cloyne/card-reader/README.md

# Cloyne Card Reader

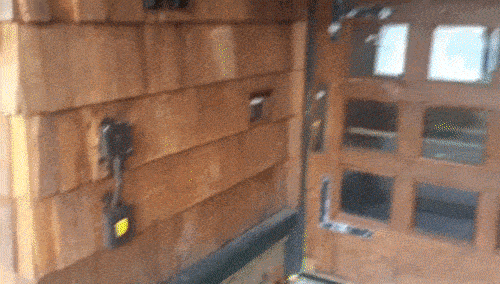
[picture p1: media/frontdoor_open.gif]


This card reader is installed at the front door of Cloyne Court Co-op. It is built off of Mike Zhong's Physics 111a final project. It scans Berkeley students' Cal1ID cards by RFID interaction, checks whether the ID is stored in the SD card adapter, and if so, triggers the door to open automatically. 

Included:

111a-final-proj.pdf:  Submitted overview of the final project, from Dec 2015.

arduino/a1.ino:   Code running on Arduino A1

arduino/a2_redacted.ino:   REDACTED code running on Arduino A2. Managers: contact mlyzhong@gmail.com for unredacted version

schematic/annotated.jpg:   Annotated image of circuit

schematic/README.txt:   readme of schematic

schematic/schematic.pdf:   PDF of schematic

More to come soon.
Mike
