cloyne/card-reader/media/unnamed.jpg

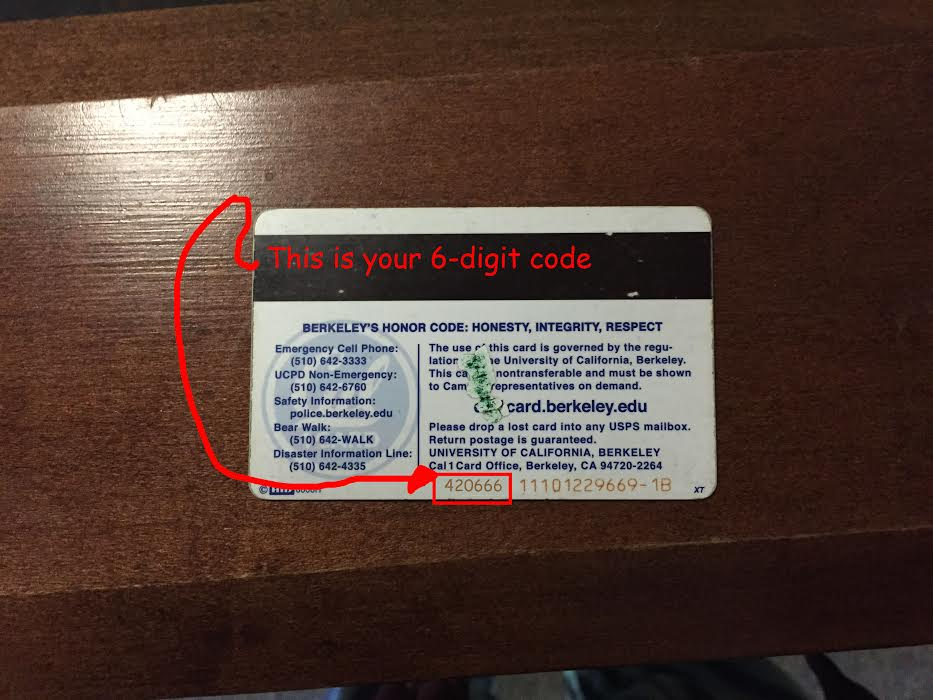
media/unnamed.jpg
