cloyne/card-reader/schematic/annotated.jpg

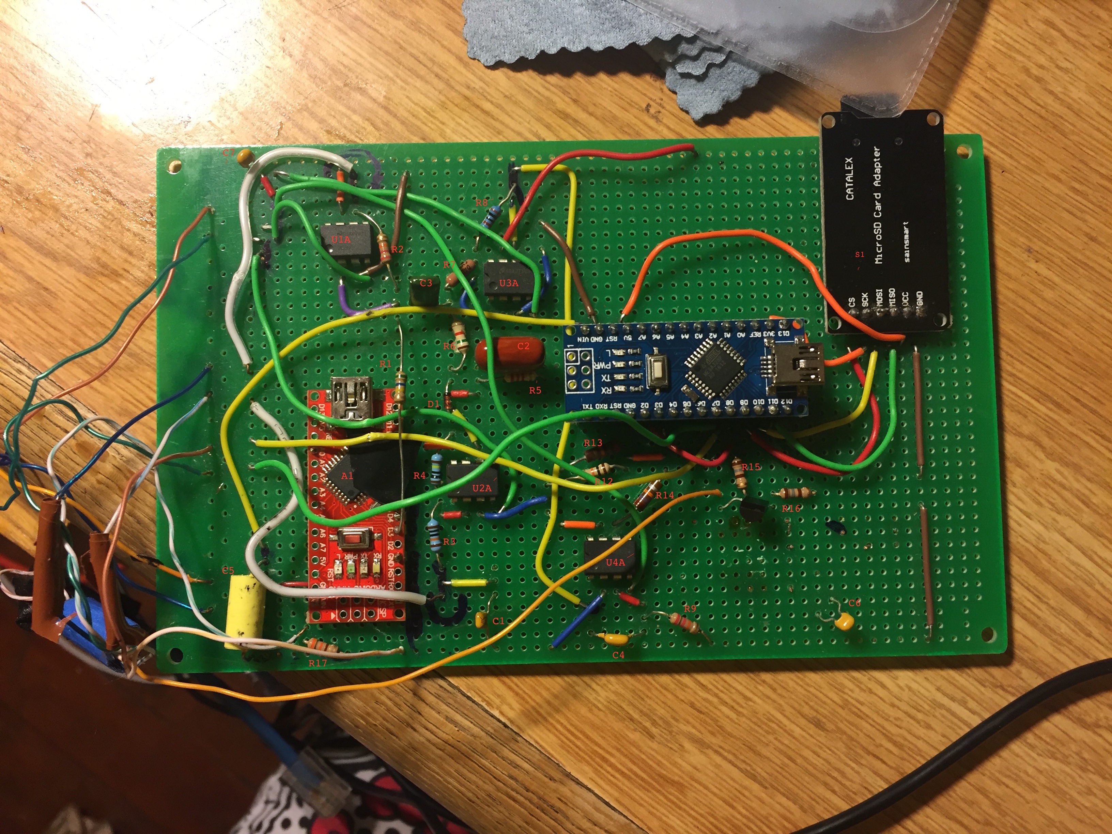
schematic/annotated.jpg
