cloyne/card-reader/schematic/schematic.pdf

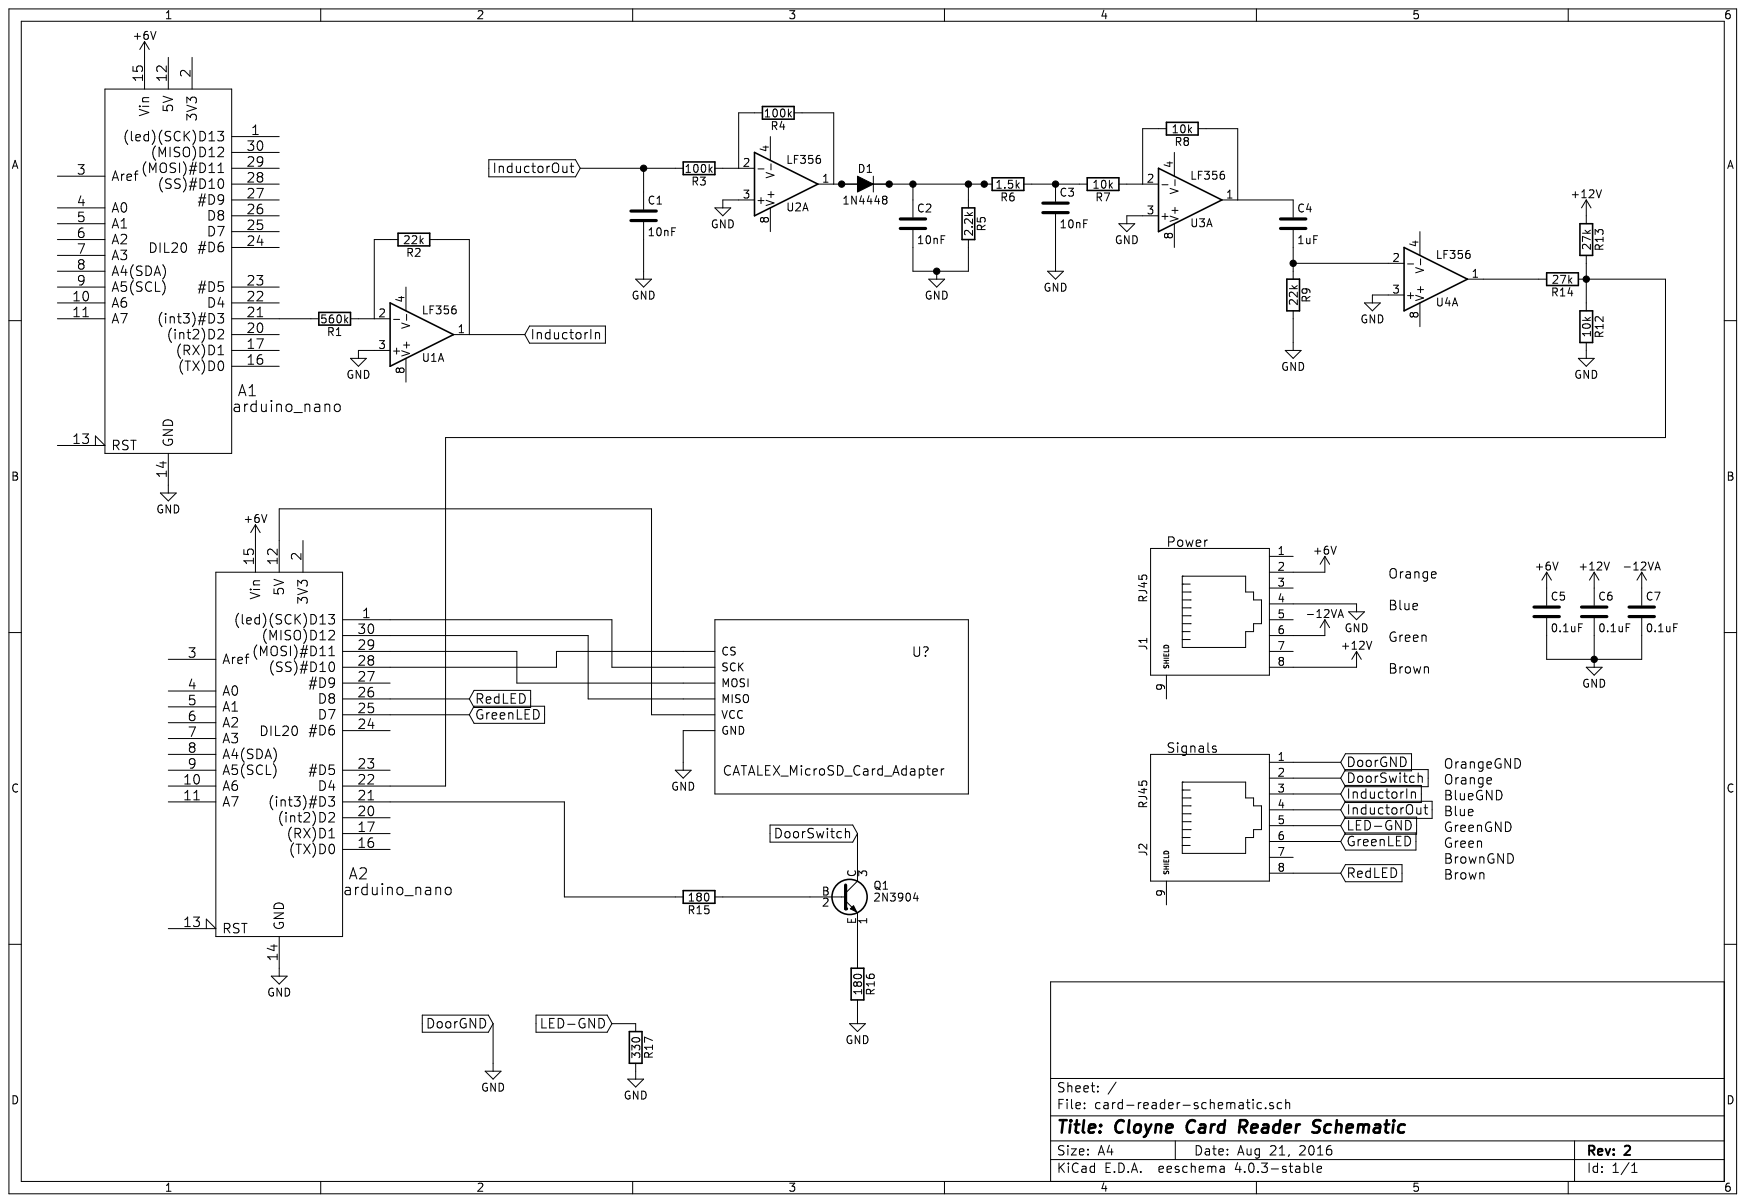
[picture p14: page 1]
