cloyne/card-reader/schematic/kicad/card-reader-schematic.sch

## KiCad design schematic/kicad/card-reader-schematic.sch (2016-08-22)

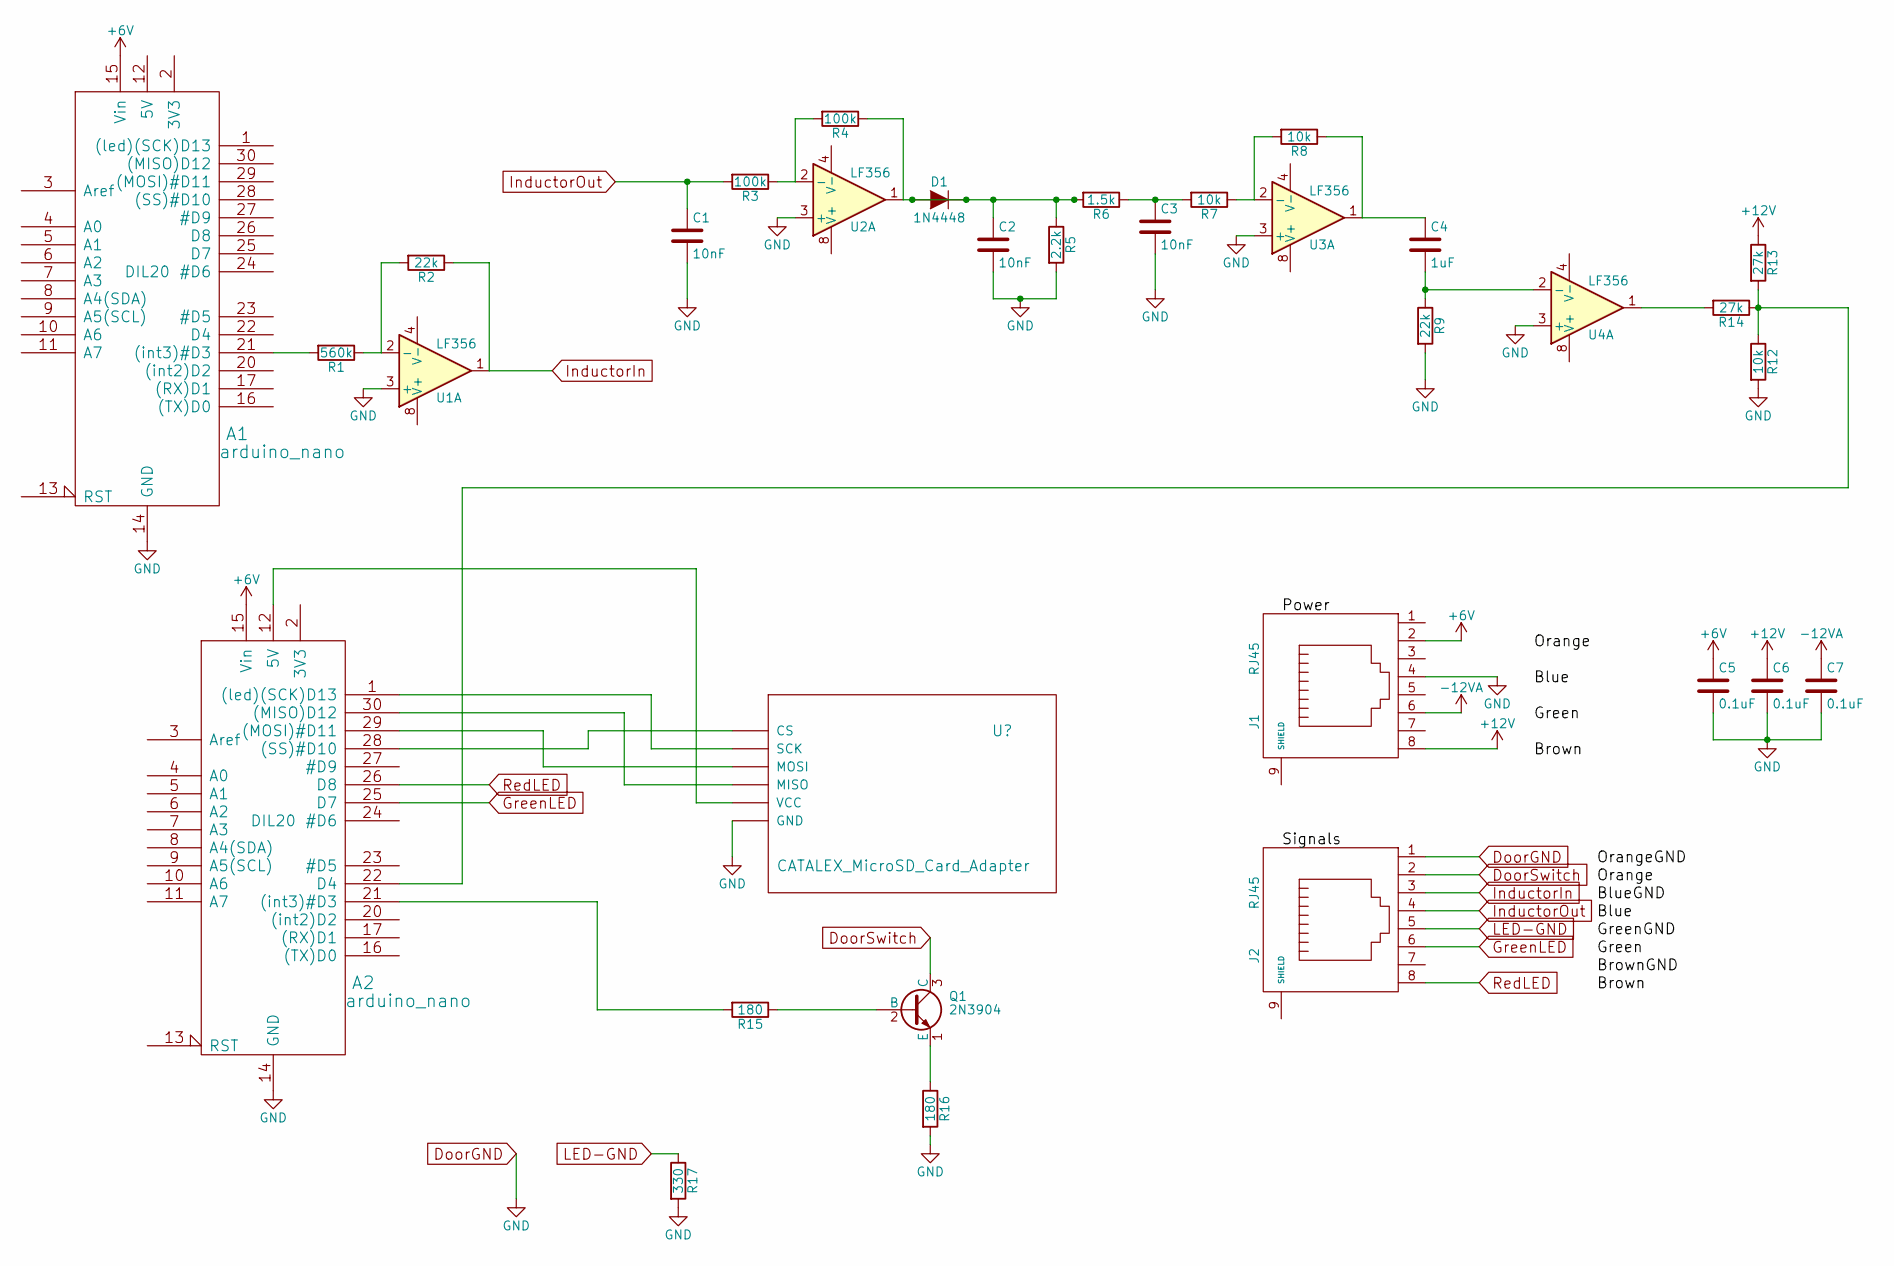
[picture p15: schematic card-reader-schematic.sch]

Parts:
A1, A2: arduino_nano; DIL20
C1, C2, C3: 10nF
C4: 1uF
C5, C6, C7: 0.1uF
D1: 1N4448
J1, J2: RJ45
Q1: 2N3904
R1: 560k
R2, R9: 22k
R3, R4: 100k
R5: 2.2k
R6: 1.5k
R7, R8, R12: 10k
R13, R14: 27k
R15, R16: 180
R17: 330
U1, U2, U3, U4: LF356

Connections:
+6V: A1.15 (Vin), A2.15 (Vin), C5.1, J1.2
+12V: C6.1, J1.8, R13.1
-12VA: C7.1, J1.6
DoorGND: A1.14 (GND), A2.14 (GND), C1.2, C2.2, C3.2, C5.2, C6.2, C7.2, J1.4, J2.1, R5.2, R9.2, R12.2, R16.2, R17.2, U1.3 (+), U2.3 (+), U3.3 (+), U4.3 (+)
DoorSwitch: J2.2, Q1.3 (C)
GreenLED: A2.25 (D7), J2.6
InductorIn: J2.3, R2.1, U1.1
InductorOut: C1.1, J2.4, R3.2
LED-GND: J2.5, R17.1
unnamed: A1.21 ((int3)#D3), R1.2
unnamed: A2.21 ((int3)#D3), R15.2
unnamed: A2.22 (D4), R12.1, R13.2, R14.1
unnamed: C2.1, D1.1 (K), D1.2 (A), R4.1, R5.1, R6.2, U2.1
unnamed: C3.1, R6.1, R7.2
unnamed: C4.1, R8.1, U3.1
unnamed: C4.2, R9.1, U4.2 (-)
unnamed: Q1.1 (E), R16.1
unnamed: Q1.2 (B), R15.1
unnamed: R1.1, R2.2, U1.2 (-)
unnamed: R3.1, R4.2, U2.2 (-)
unnamed: R7.1, R8.2, U3.2 (-)
unnamed: R14.2, U4.1
RedLED: A2.26 (D8), J2.8
