cloyne/card-reader/(threads)

Thread 1 (2016-08-22):

Change Power Ethernet Connection

mlyzhong, 2016-08-22:
As the project currently stands, if you switch the two ethernet cables (power and signal), you will blow out arduino A2. Plans to change the power ethernet connection to USB.

mlyzhong, 2016-10-02:
Done!

Closed 2016-10-02.
