cloyne/card-reader/(commit log)

2016-08-22 Added Final Project pdf and Draft Schematic.
2016-08-22 Added an annotated circuit jpeg, and readme for the schematic.
2016-08-22 Edited schematic, included .sch file for edits too.
    [card-reader-schematic.sch]
2016-08-22 added other relevant schematic files, too
2016-08-22 Organized into folders.
    [card-reader-schematic.sch]
2016-08-22 Added (redacted) arduino code. Redacted for security reasons.
2016-08-22 Removed untracked files.
    [card-reader-schematic.sch]
